wware/CylindricalPrinter/gallery/printer_2.png

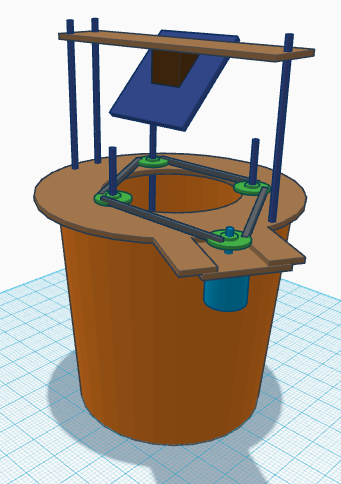
gallery/printer_2.png
