wware/CylindricalPrinter/gallery/printer_1.png

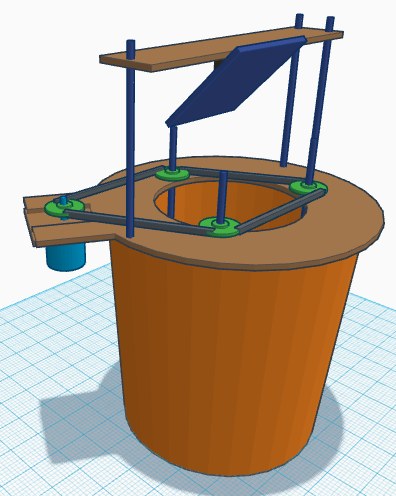
gallery/printer_1.png
