wware/CylindricalPrinter/electronics/README.md

Electronics for the cylindrical printer
==

Shopping list:

* a power strip with a long cord
* the stepper controller:  CNC Single Axis TB6600 Stepper Controller,
  part number [HY-DIV268N-5A](http://www.aliexpress.com/item/HY-DIV268N-5A-Single-Axis-CNC-Stepper-Driver-TB6600-0-2-DC-5A-Two-Phase-Hybrid/1104692237.html)
* the 12 volt switching supply: [LIHUA 120W](http://www.aliexpress.com/item/120W-12V10A-Switching-Power-Supply-Adapter-a-lot-for-led-strip-led-lighting-project-Transformers-in/1455201598.html)
  (12v, 10 amp) Regulated Switching Power Supply
* an Arduino Uno board
* 4-position [terminal strip](http://www.radioshack.com/product/index.jsp?productId=2103982)
  for stepper connections: A+, A-, B+, B-

You'll also need (or at least, I needed):

* a NEMA-23 motor, part number
  [266-F4.2A-1](http://www.hubbardcnc.com/index.php?main_page=product_info&products_id=362),
  125 oz-in, possibly overkill
* an [InFocus IN114A projector](http://www.newegg.com/Product/Product.aspx?Item=0B1-00PJ-00003),
  the biggest expense in the project, mine cost $350
