wware/CylindricalPrinter/mechanics/template.pdf

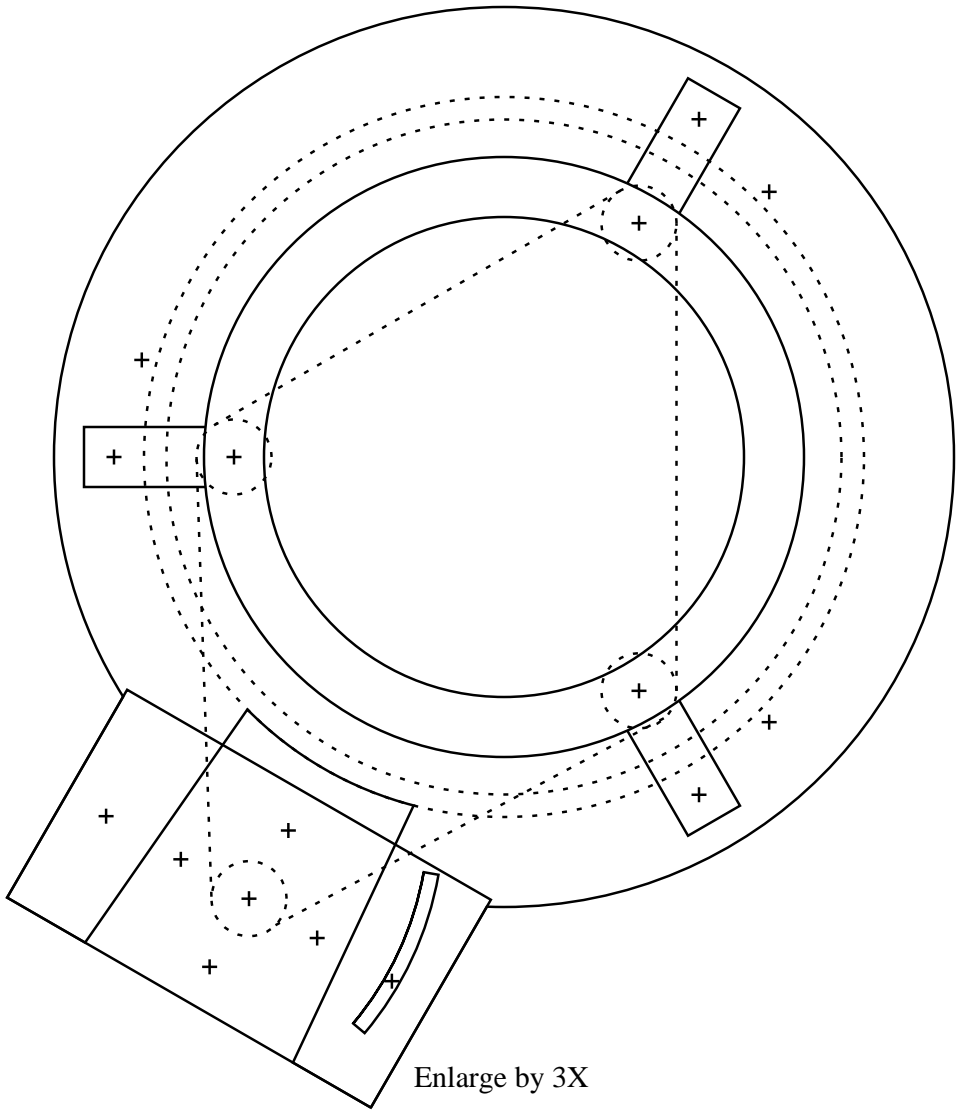
[picture p3: figure]
Enlarge by 3X
