wware/CylindricalPrinter/gallery/bicycle_chain.png

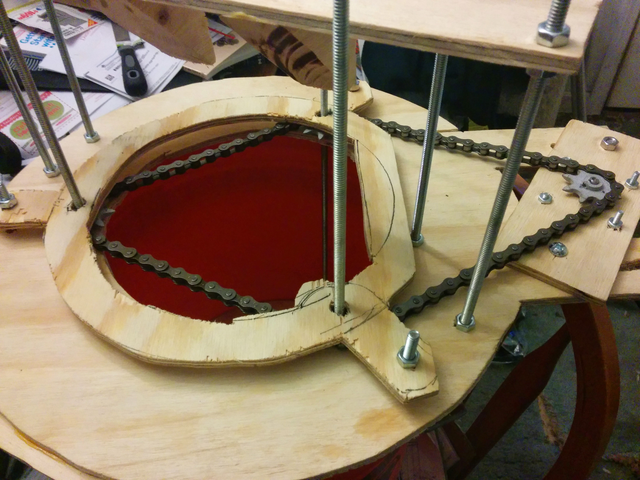
gallery/bicycle_chain.png
