wware/CylindricalPrinter/gallery/bubble_bubble_toil_and_trouble.png

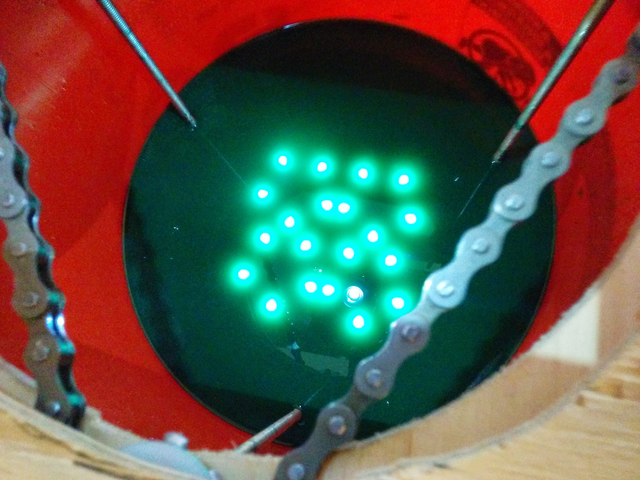
gallery/bubble_bubble_toil_and_trouble.png
