wware/CylindricalPrinter/gallery/dumpy_dour_dodecahedra.png

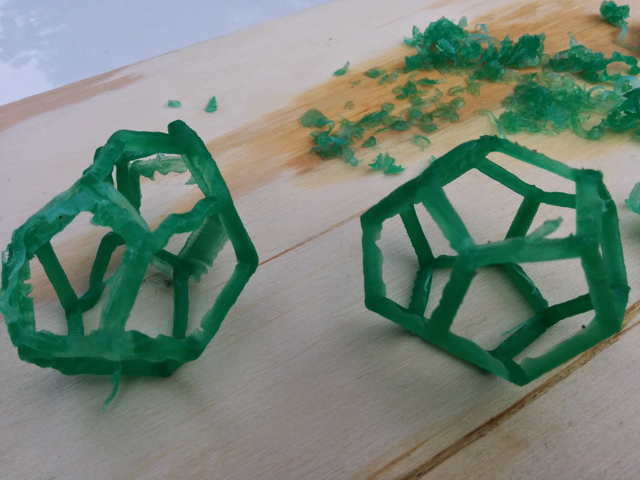
gallery/dumpy_dour_dodecahedra.png
