wware/CylindricalPrinter/gallery/more_bike_chain.png

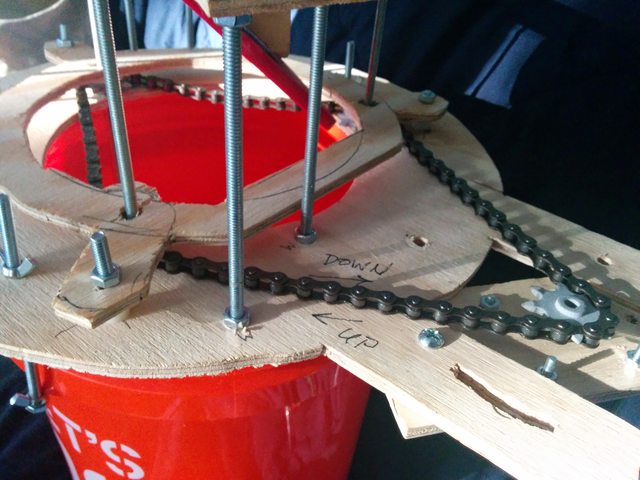
gallery/more_bike_chain.png
