wware/CylindricalPrinter/gallery/projector_overhead.png

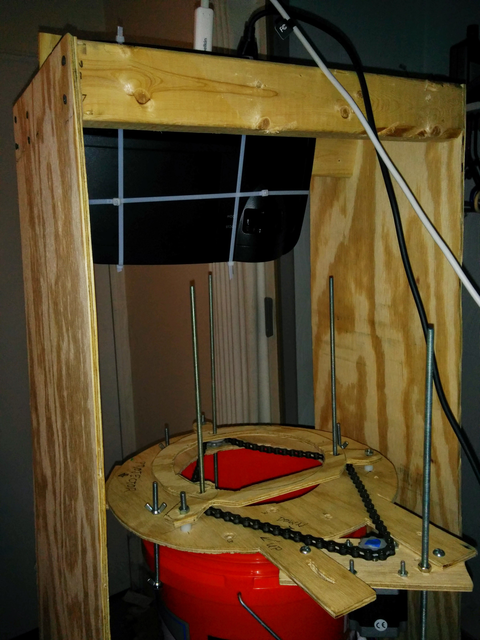
gallery/projector_overhead.png
