wware/CylindricalPrinter/gallery/trimming_sprockets.png

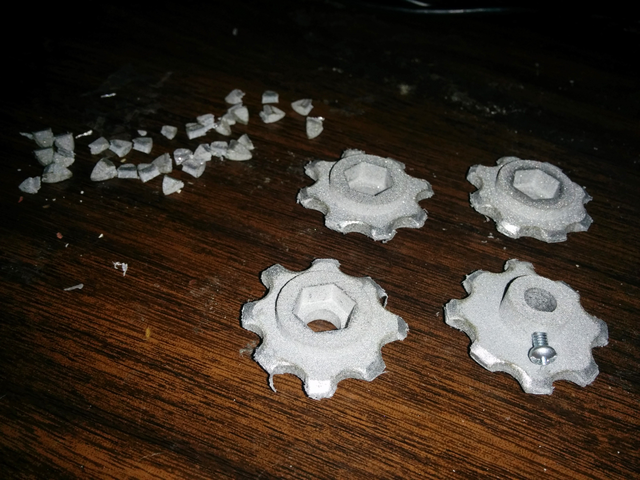
gallery/trimming_sprockets.png
