wware/CylindricalPrinter/mechanics/stepper_sprocket.stl

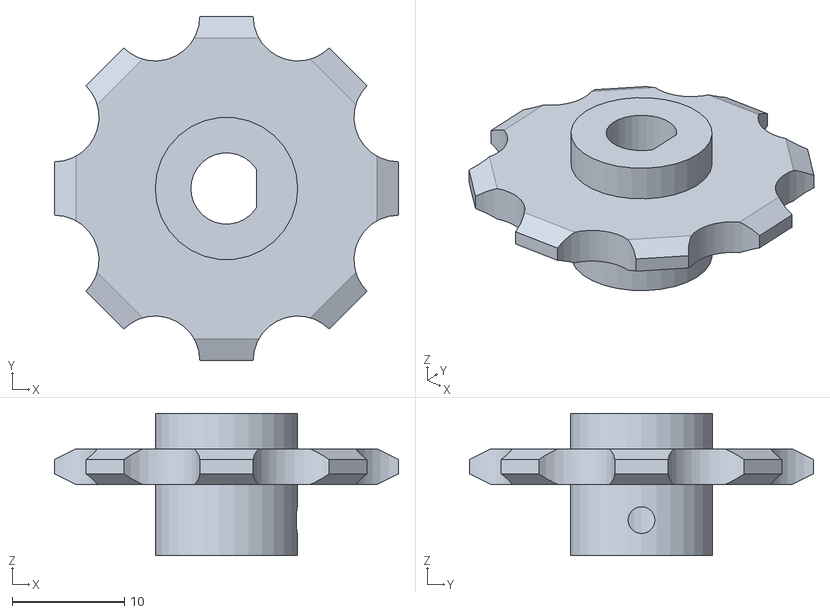
[picture p10: CAD file, 2018-11-26]
mechanics/stepper_sprocket.stl
30.7 x 30.7 x 12.7
