wware/CylindricalPrinter/software/models/dodecahedron.stl

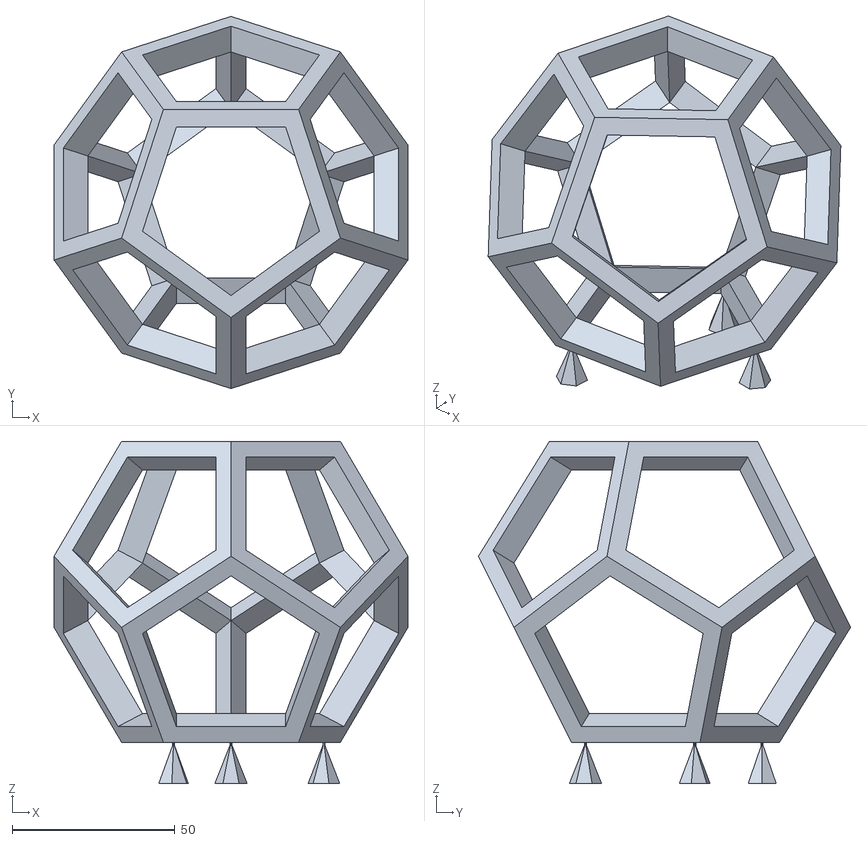
[picture p11: CAD file, 2014-09-13]
software/models/dodecahedron.stl
108.7 x 114.3 x 105.2
