wware/CylindricalPrinter/mechanics/hex_sprocket.stl

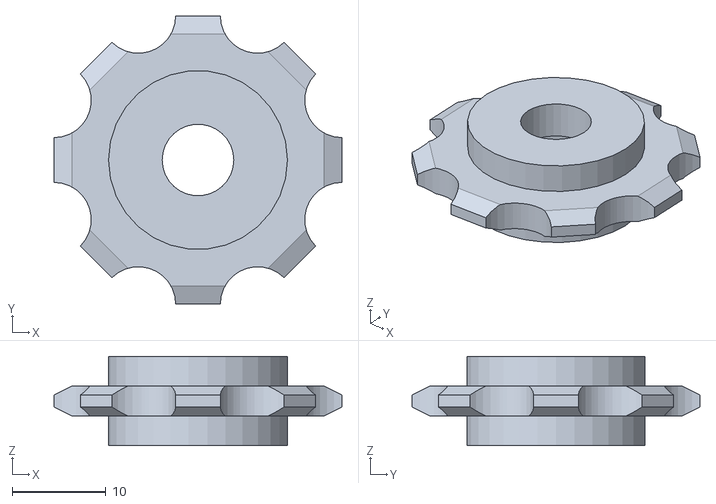
[picture p12: CAD file, 2018-11-26]
mechanics/hex_sprocket.stl
30.7 x 30.7 x 9.53
