wware/CylindricalPrinter/software/models/smallish.stl

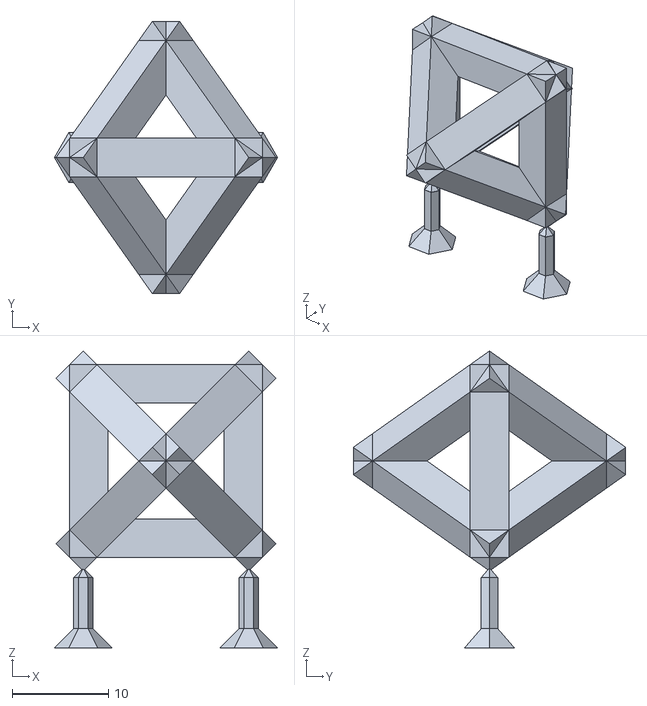
[picture p13: CAD file, 2014-09-13]
software/models/smallish.stl
23.2 x 28.3 x 30.8
