wware/CylindricalPrinter/mechanics/printer.stl

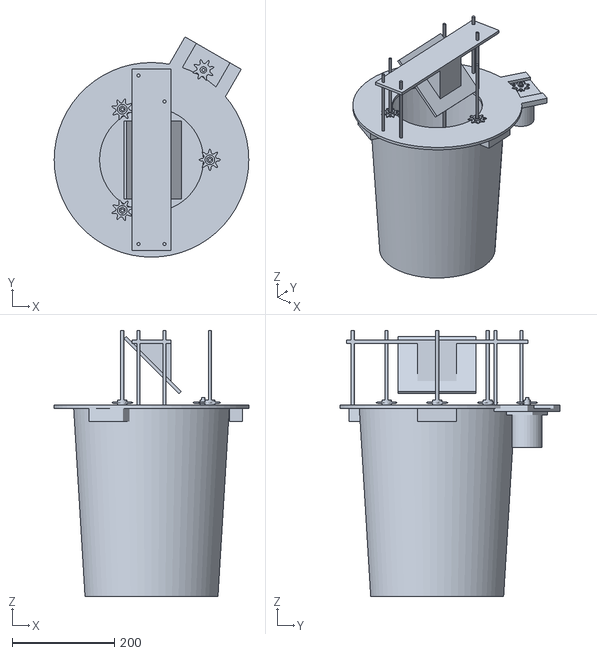
[picture p14: CAD file, 2014-08-22]
mechanics/printer.stl
381.0 x 431.2 x 520.7
