wware/CylindricalPrinter/software/models/wware_keyfob.stl

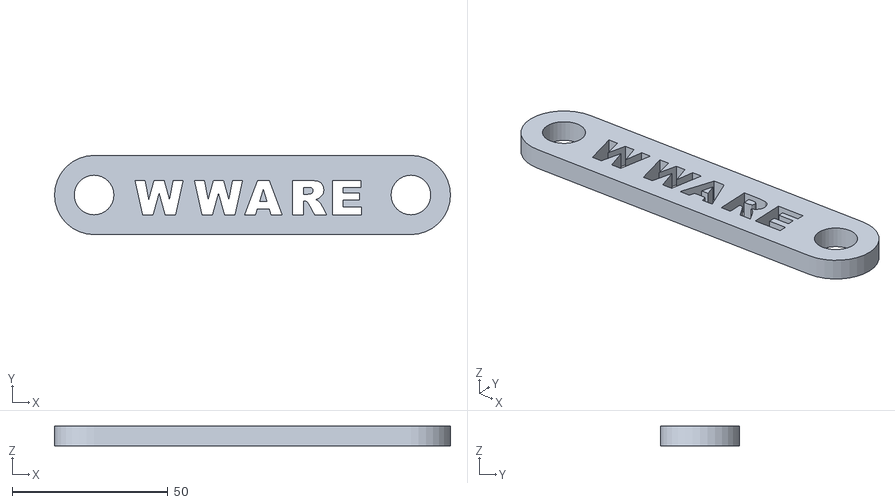
[picture p15: CAD file, 2014-09-04]
software/models/wware_keyfob.stl
127.0 x 25.4 x 6.35
