wware/CylindricalPrinter/software/models/Hollow_Dodecahedron.stl

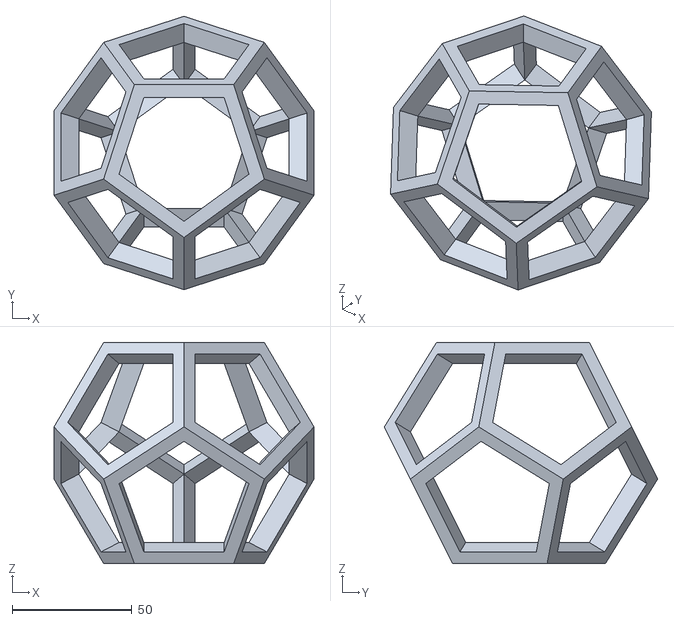
[picture p16: CAD file, 2014-08-20]
software/models/Hollow_Dodecahedron.stl
108.7 x 114.3 x 92.5
