wware/CylindricalPrinter/mechanics/sprockets.scad

/* http://www.thingiverse.com/thing:426854 */

module sprocket_tooth() {
    s = 1;
    intersection() {
        difference() {
            translate([-1/4,0,-1/16])
                cube([1/2,3/8,1/8]);
            translate([1/4, 0, -1/8])
                cylinder(h=1/4, d=5/16, $fn=30);
            translate([-1/4, 0, -1/8])
                cylinder(h=1/4, d=5/16, $fn=30);
        }
        translate([0, -0.05, 0])
            scale([1, 1, 0.5])
                rotate([-45, 0, 0])
                    translate([-1/2, 0, 0])
                        cube([1, 1, 1]);
    }
}

module sprocket(teeth, hub_diameter) {
    pitch = 1/2;   // bicycle chain, 1/2 - 1/8
    theta = 360.0 / teeth;
    r = (pitch / 2) / tan(theta / 2);
    for (i = [0 : teeth-1])
        rotate(theta*i, [0, 0, 1])
            translate([0, -r, 0]) sprocket_tooth();
    translate([0,0,-1/16])
        cylinder(h=1/8, d=2*r-0.5, $fn=30);
    translate([0,0,-3/16])
        cylinder(h=3/8, d=hub_diameter, $fn=30);
}

module StepperSprocket(teeth, axle_diameter) {
    dcut = 0.5 * (0.21/0.250) * axle_diameter;
    difference() {
        union() {
            sprocket(teeth, 0.5);
            translate([0, 0, -5/16])
                cylinder(h=5/16, d=0.5, $fn=30);
        }
        difference() {
            translate([0,0,-0.5])
                cylinder(h=1, r=axle_diameter/2, $fn=30);
            translate([dcut, -0.5, -0.5])
                cube([1, 1, 1]);
        }
        translate([0, 0, -3/16])
            rotate([0, 90, 0])
                cylinder(h=1, d=3/32, $fn=30);
    }
}

module HexNutSprocket(teeth, wrench_size) {
    difference() {
        sprocket(teeth, 0.75);
        intersection_for(n = [1 : 3])
            rotate(60 * n, [0, 0, 1])
                translate([-0.5 * wrench_size, -0.5, -0.5])
                    cube([wrench_size, 1, 1]);
    }
    difference() {
        translate([0, 0, 1/32])
            cylinder(h=5/32, d=0.75, $fn=30);
        cylinder(h=1, d=0.3, $fn=30);
    }
}

teeth = 8;
wrench_size = 0.43;

/* STL files are dimensionless and I usually like to use inches,
 * but the Formlabs machine prefers millimeters, and OpenSCAD
 * seems to want them also.
 */

scale([25.4, 25.4, 25.4]) {
    // StepperSprocket(teeth, 1/4);

    HexNutSprocket(teeth, wrench_size);
}
