wware/CylindricalPrinter/(commit log)

2014-08-20 A bunch of work, July and August 2014.
    [Hollow_Dodecahedron.stl, dodecahedron.stl, dodecahedronWsupports.scad, printer.scad, printer.stl, simple.dxf, simple.scad, sprockets.scad]
2014-08-21 use a set screw on the stepper sprocket
    There are plenty of 4-40 set screws available, like
    http://www.mcmaster.com/#93445a170/=tdk0uz, which specifies a hex key size of
    0.05" (driver: http://www.mcmaster.com/#7400a11/=tdk1pc). Or you can pick up a
    4-40 machine screw at Home Depot or Loews or Radio Shack, and skip the hex key.
    The hole into which it fits has a 3/32" diameter.
    [sprockets.scad]
2014-08-22 Move a support out of the way of the bike chain.
    [printer.scad, printer.stl]
2014-08-25 A cover so the hex nut so doesn't move up or down.
    [sprockets.scad]
2014-08-25 add cover plate, only 3 rods to hold up mirror
    [printer.scad]
2014-08-26 Postscript template for plywood cutting and drilling.
2014-08-26 Add a couple of images, improve the README
2014-08-28 Get GPIO working on RPi to drive the stepper.
    Two things learned this evening.
    (1) Run the server as root, or else no GPIO for you!
    $ sudo su -
    % cd ~pi/CylindricalPrinter/software
    % source setup.sh
    % ./printer.py
    (2) In order to pip-install RPi.GPIO, you need to first
    sudo apt-get install python-dev
2014-08-28 a startup script for the raspberry pi
2014-08-28 faster stepper, bug fix, skip sudo because it runs as root
    [printer.py]
2014-08-29 fix indentation
    [sprockets.scad]
2014-09-03 Calibration image, with IP address
2014-09-04 cheesy little keyfob as test print object
    [wware_keyfob.stl]
2014-09-05 Dodecahedron: supports shorter and narrower, make four at a time
    [dodecahedron.stl, dodecahedronWsupports.scad]
2014-09-05 Performance improvements, bug fixes, debug stuff.
    [printer.py]
2014-09-05 Add stepper polarity bit. Thought I'd already done this.
2014-09-06 bug fix, and scriptability
    [printer.py]
2014-09-07 Fix Arduino bugs, use the Arduino to control the stepper.
    [config.py]
2014-09-07 More conservative design for sprocket tooth.
    [sprockets.scad]
2014-09-07 Remove Raspberry Pi stuff. Clean stuff up.
    [simple.dxf, simple.scad]
2014-09-07 cleanup, refactoring, remove mirror supports
    [dodecahedron.stl, dodecahedronWsupports.scad]
2014-09-12 THIS ACTUALLY WORKED GREAT
    Changes involved
    (1) Slow the stepper way down.
    (2) Eliminate acceleration and deceleration. Those would still be useful when
    not printing, so bring them back in just those cases.
    (3) Eliminate hysteresis. Seems to be unnecessary. Still exists in the code,
    could be removed for simplification. Previous hysteresis had been done in
    the wrong direction, doh.
    (4) Give a settling time after each motor move.
    (5) Much smaller model for good quick tests.
    Where to go next? I still need more experience with printing (hopefully good
    prints). I'm learning the various failure modes. I need new plywood parts, esp
    the build platform which is now covered with crap. In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
    [dodecahedron.stl, dodecahedronWsupports.scad, smallish.scad, smallish.stl]
2014-09-12 calibration results
2014-09-13 Another template to simplify plywood cut-out.
2014-09-13 Longer supports on the dodecahedron.
    [dodecahedron.stl, dodecahedronWsupports.scad]
2018-11-26 STL files for the two sprockets
    [hex_sprocket.stl, stepper_sprocket.stl]
